YSKM129129/SRC_FOC/docs/TIGERS_FOC_REVIEW_2026-09-17.md

# Tigers 与 SRC-FOC 控制链路对照

日期：2026-09-17。基于本次读取的磁盘源码；未连接电机、示波器或调试器进行运行测量。本报告中的“确定”指代码行为确定，不代表已证实现场故障的唯一根因。

## 结论

SRC-FOC 已有完整的基本 FOC 运算链：电流采样、Clarke/Park、双 PI、逆 Park、带零序注入的 SVPWM，以及速度外环、指令斜坡、母线电压补偿和电压矢量限幅。它不是缺少某个坐标变换公式。

当前最需要补齐的是：采样窗口约束、角度与采样/输出时刻的对应关系、校准有效性验证，以及能解释故障的同步波形记录。

优先发现：

1. 默认速度模式只能输出最多 2 A 的 Iq。转矩模式的 10 A 上限在这里不起作用，这是出力受限的确定原因之一。
2. 当前调制幅值 0.8 下，固定 ADC 时刻的最坏采样余量只有约 0.04 us，不能保证所有电角度下均采到有效的低侧电流。
3. 电流环 20 kHz 使用 4 kHz 更新的角度，且允许旧角度维持接近 20 ms。没有角度时间戳补偿，对中高速和编码器干扰尤其不利。
4. 零位校准的验收条件太宽，历史校准不绑定电机、相序或极对数。校验和正确不等于电角度正确。
5. 调试模式没有通信遥测，故障后主循环阻塞在灯语中。现有数据不足以判断是哪一个限制在起作用。

这次没有修改运行固件或提高功率参数。修改前应先固定测量基线，并逐项验证，避免多个参数同时变化后无法归因。

## 源码范围与版本

Tigers 根目录：`F:/ROBOCUP/Tigers/Firmware-master/Firmware-master`。

重点阅读 `src/motor2019/drive_ctrl.c`、`drive_motor.c`、`adc.c`、`drive.c`、`usart1.c`，以及 `src/shared/math/pi_ctrl_s12.c`、`src/shared/drv/mcu_motor.c`、`src/main2019/test/test_motor.c`。也检查了 dribbler 控制入口；它采用不同的换相/电流控制方式，不能直接当作本板的 FOC 模板。

这是仓库中的 motor2019 实现，不代表 Tigers 所有代际的最新方案。它使用 STM32F0、特殊的电流测量开关序列、定时器编码器和 Hall；本板是 G474、低侧双电阻、DRV8353 和 MT6816 SPI 编码器。应借鉴设计方法，不能照抄寄存器、采样序列或 PI 数值。

本次 SRC-FOC 源码 SHA256：

| 文件 | SHA256 |
| --- | --- |
| `Core/Src/foc_control.c` | `3F3E9215C1DFFA4A81A5C977EA0CA8F14353FC991034163DE43B486B290C863E` |
| `Core/Src/adc.c` | `C9E085C2B08891D7063B9E440D262513369447463852EAF2CB354A5B123B9725` |
| `Core/Src/tim.c` | `E3ED4B2470C6BFB7179B063B625C1A07E38F8FEC038E061CD5672C65A15D7EC6` |
| `Core/Src/main.c` | `78E518367C15589B17DEBE08C63D6621758F12A5B4F9BC2B383B7A9F56AEAC6E` |

前面讨论过的“Clarke 缺 2/3”“没有速度环”“只有 0.05 电压限幅”已不适用于这份源码：Clarke 已修正，速度环已加入，限幅已变为 0.8，调制也已有零序注入。

## 主要发现

### 1. 速度环的 2 A 限制与转矩模式的 10 A 是两回事

证据：`Core/Src/main.c:18` 默认启用模拟指令，`:20` 选择 `FOC_MODE_SPEED`，`:21` 为 1000 rpm。`Core/Src/foc_control.c:31` 定义 `SPEED_LOOP_CURRENT_LIMIT=2.0f`，`:792` 开始的速度 PI 将输出限制到正负 2 A。

因此外部 CAN/SPI 指令在默认调试模式下不生效。`MAX_IQ_CURRENT=10` 只限制转矩指令路径，不会把速度环限幅放大。

按代码中的 25.1 mN*m/A 换算，2 A 对应名义轴转矩 50.2 mN*m，即 0.0502 N*m；该值还依赖 Kt 与本项目 Iq 定义一致、角度/采样正确。不能把它直接视为实测转矩，减速器输出还要乘减速比与效率。

验证：在受控负载下记录速度目标/反馈和 `iq_ref_target`。如果速度下降时 `iq_ref_target` 一直为 2 A，且实际 Iq 跟得上，当前限制就是速度环出力上限。若实际 Iq 跟不上，应先检查电压饱和与反馈，不能靠增大上限解决。

后续将电机额定电流、允许短时电流、转矩模式限制、速度环限制、软件保护阈值分别定义，并注明单位。不要直接把速度上限改成 10 A；现有板级热容量和相电流测量尚未证实支持该值。

### 2. 固定电流采样窗口没有可靠覆盖 0.8 调制范围

证据：`Core/Src/tim.c:47` 配置 170 MHz、ARR=2125、中心对齐，PWM 约 40 kHz；`:96` 将 CH4 比较值设为 170，ADC 在 CNT=0 后约 1 us 触发。`Core/Src/adc.c:48` 为同步时钟除 4，即 42.5 MHz；`:82` 每路采样 12.5 周期，12-bit 转换另需约 12.5 周期，两路顺序转换。

以 CNT=0 为时刻零，忽略触发同步延迟：

```text
ADC 触发                  1.000 us
第一路采样保持时刻         1.294 us
第一路转换结束             1.588 us
第二路采样保持时刻         1.882 us
第二路转换结束             2.176 us
```

关键是采样保持时刻必须位于有效电流窗口内；不能简单要求整个数字转换过程都早于开关沿。

当前 `svpwm()` 带零序注入。电压矢量幅值 m 时，所有角度上的最大占空比为 `0.5 + sqrt(3)*m/4`。PWM2 下，从 CNT=0 到最早高侧输入上升沿的时间为 `ARR*(1-duty_max)/170 MHz`。

| m | 最大占空比 | 最早开关指令边沿 | 距第二路理想保持时刻的余量 |
| --- | --- | --- | --- |
| 0.80 | 84.64% | 1.920 us | 0.038 us |
| 0.70 | 80.31% | 2.461 us | 0.579 us |
| 0.65 | 78.15% | 2.732 us | 0.849 us |

上述为浮点理想计算，CCR 整数截断会再减少几 ns；尚未计入 ADC 触发同步、实际栅极切换、放大器瞬态和噪声余量。故“已把 ADC 采样时间缩短”仍不足以证明 0.8 全范围可靠。

影响：在特定电角度或较大电压指令下，某一路可能读到切换期间的值或无效低侧电流，造成与电角度相关的电流纹波、抖动和误过流。这个风险只有在实际指令接近窗口边界时才直接相关；低负载低调制时不能仅凭此断定根因。

验证：记录 CCR1/2/3、ADC 原始值和触发时刻；用示波器观察 SOA/SOB 与对应低侧 Vgs。在相同低速负载下对比有充分余量的调制范围与原配置。降低限幅只用于定位，并不是最终解决高速出力的方法。

应借鉴 Tigers 的“先安排可测量的开关状态，再执行控制”：按两个被测相的实际导通窗口判定采样有效性；选择合适触发位置，或评估双 ADC 同步采样。双 ADC 方案需重新分配当前 ADC2 的母线/温度采样，不能直接修改一个开关就完成。

### 3. 角度没有与电流和 PWM 输出时刻对齐

证据：`Core/Src/foc_control.c:813` 每 10 次 40 kHz ADC 回调发起编码器读取，即约 4 kHz；`:842` 每 2 次执行一次电流环，即 20 kHz；`:904` 直接使用最近一次 `angle` 做 Park；逆 Park 又使用同一个 theta。

在读取开始的那一次 ADC 中断中，新角度尚未通过 DMA 返回，当前控制必然使用上一笔数据。现有 `enc_last_valid_ms` 是毫秒级完成时间，不是传感器角度的采样时间。

8 对极下，仅 250 us 的角度保持对应的电角度变化为：

| 转速 | 电角度变化 |
| --- | --- |
| 1000 rpm | 12 度 |
| 3000 rpm | 36 度 |
| 6000 rpm | 72 度 |
| 9000 rpm | 108 度 |

这不是每一时刻的固定误差，还未包含传感器内部延迟、SPI 传输、中断和 PWM 生效延迟。1000 rpm 时仅这一项通常不足以解释很大的转矩损失；但在更高转速下不能忽略。

`encoder_healthy()` 在 `:253` 允许最后有效角度的年龄小于 20 ms。1000 rpm、8 对极时，20 ms 已跨过约 960 度电角度。它适合作为较宽松的通信存活尺度，不适合作为继续施加正常转矩的角度有效性尺度。

Tigers 在 `drive_motor.c:145` 使用 PWM 事件触发 DMA 捕获编码器计数，`drive_ctrl.c:314` 取与电流序列对应的计数，并利用 Hall 转换做修正。这种硬件捕获不能直接搬到 SPI 编码器，但时间对应关系必须建立。

建议为角度增加微秒时间戳、序号和实际采样延迟模型。分别估算电流采样时刻的角度和 PWM 实际生效时刻的角度；有条件地采用 `theta(t)=theta_sample+omega_e*(t-t_sample)`，并限制预测时长。不要用一个固定“超前角”覆盖所有转速，也不要只提高 SPI 波特率就认为解决了角度年龄问题。

### 4. 校准成功的条件不足以证明磁场零位正确

证据：`Core/Src/foc_control.c:648` 在已有校准时跳过机械对齐；`:667` 只要求旋转量大于理想值的 25%，没有上限、稳定性或重复性验证。8 对极的理想半电周运动为 22.5 度机械角，目前超过 5.625 度就可能通过。

`:682` 用单次最终角度写入零偏。`calibration_load()` 在 `:328` 检查格式、校验和和范围，但没有相序、极对数、电机标识或校准质量记录。换相线、移动磁铁、更换电机后旧数据仍可能被接受。

影响：加载一个数学上合法但物理上错误的零偏，仍可能转动，但每安培有效转矩下降，正反转不对称或周期性抖动。仅在这个错误坐标系下观察 Id 接近零，也不能独立证明磁场零位正确。

验证：轻载状态下做多角度、正反方向、重复对齐，记录指令电角度和实测机械角；验证极对数、方向和最终保持段的角度方差。校准记录加入配置版本和质量指标，提供明确的重校准入口。不要在未保证电流测量和限流可靠前扩大开环对齐电压。

### 5. 关键波形不可见，难以区分内环和外环问题

证据：`Core/Src/main.c:76` 的调试分支只重复应用模拟命令；CAN/SPI 遥测在另一分支。正常通信模式也只是约 100 Hz 的少量瞬时读数。`FOC_PollDriverFault()` 在故障后进入无限灯语循环，无法继续从主循环发出诊断。

Tigers 的 `adc.h` 定义每 ms 20 个样本和双缓冲；`drive_ctrl.c:544` 提供记录 Iq 目标/实际、Id/Iq、电压等模式；`usart1.c:178` 同时报告电流 PI 和速度 PI 饱和标志。`mcu_motor.c:534` 提供记录阶跃的命令。100 Hz 瞬时遥测不能可靠识别几百 Hz 或 kHz 振荡，还可能混叠。

优先补充一次性 RAM 录波：以电流环频率采样 256~512 点，记录时间戳、ADC_U/V、Iu/Iv、Id/Iq、Iq 目标、Vd/Vq、CCR、角度年龄、饱和标志和状态；在故障或阶跃附近冻结，再低优先级传输。按实际每条记录大小核对内存预算，避免在高频中断内 printf 或阻塞传输。

还应记录 ADC 中断执行时间、最大执行时间、丢帧计数，以及写 CCR 到实际更新事件的相位。当前 RCR=3、40 kHz PWM、20 kHz 控制组合的平均频率合理，但平均频率不证明每次计算均赶上预装载生效期限。

### 6. 母线采样存在软件读取竞态

证据：`Core/Src/foc_control.c:78` 启动 ADC2 两通道序列后，分别轮询并读取温度和母线；`Core/Src/adc.c:133` 为单转换 EOC、AutoWait 关闭、数据保留模式。两个转换各约 1.41 us，远快于最坏中断抢占时间。

若 CPU 在第一次读取前被电流中断抢占，两次转换可能都已结束。一个 DR 寄存器并不能保存两个结果；OVR 或 EOC 合并可能导致第二次轮询超时。运行时调用忽略返回失败，母线补偿会继续使用旧值。

这是确定存在的竞态窗口，是否已触发需要统计 ADC2 OVR、超时次数和母线数据年龄。建议单独采母线通道，或用 DMA 存两路完整序列。再增加数据年龄检查，避免把通信/转换失败误判为稳定供电。

### 7. 当前保护不能当作准确的 10 A 瞬时限流

`Core/Src/foc_control.c:884` 实际判定是连续 30 个 20 kHz 控制样本越限，即约 1.5 ms 的资格窗口；附近注释仍写 3 次、150 us。`:863` 启动 blank 阶段有 20 个样本，即约 1 ms，在使能桥臂和施加零矢量时跳过软件相电流保护。

这些行为不一定是抖动根因，但会让“没有报错”等同于“电流安全”的判断失效。转矩目标上限和保护阈值均为 10 A，也缺少纹波与超调余量。DRV8353 自身 OCP 仍然存在，但它的 VDS/分流输入阈值不能直接等同于这条软件 10 A 阈值。

应重新核对实物额定电流和硬件保护；区分快速严重过流、短时滤波与持续热限制。保留故障快照，修正陈旧注释；不能用继续延长去抖或扩大 blank 来掩盖采样错误。

## Tigers 真正值得借鉴的部分

| 设计 | Tigers 证据 | 本项目应用方式 |
| --- | --- | --- |
| 测量状态与控制共同设计 | `drive_motor.c:44` 的测量序列、`:145` 编码器捕获；`drive_ctrl.c:298` 读取 U/V/W/W/V/U/零点 | 固定有效低侧采样窗口，给角度和 ADC 数据建立时间关系；不照搬其特殊测量脉冲 |
| 对称采样与零点参考 | `drive_ctrl.c:440` 对前后相电流样本平均，并减去本序列零点 | 对本板分别校准偏置、增益和符号；验证零点漂移。不能在有电流时任意追踪零点 |
| 清楚的物理单位 | `drive_ctrl.c` 开头注明电流 mA、电压 mV、20 kHz/1 kHz 频率 | 明确 Iq 是相峰值还是 RMS、Kt 与该定义是否匹配；电压单位与调制量分离 |
| 有参数辨识依据 | `test_motor.c:15` 多角度阶跃、`:131` 求 R/L、`:137` 推荐 PI | 在低风险电流范围下测实际电气响应和延迟，再整定 PI；不要照抄其 8 A 试验幅值 |
| 可定位问题的遥测 | `adc.c:150` 双缓冲；`usart1.c:178` 饱和标志；`mcu_motor.c:534` 阶跃录制 | 先做短时高速 RAM 波形，记录限幅来源，再考虑上位机自动分析 |
| 故障隔离与失联处理 | `drive_ctrl.c:146` 指令超时；`drive.c` 独立看门狗 | 正式机器人模式加入有定义的失联停机、故障状态机和非阻塞诊断 |

Tigers 的 `PICtrlS12SetAntiJitter()` 是速度环近零误差时缩小输出的功能，不是修复采样、相序或电角度错误的通用滤波器。盲目移植可能牺牲小负载下的静态调节能力。该版本 PI 主要是积分项和输出限幅，也不能宣称其已经具有本项目所需的完整电压矢量抗饱和。

G474 有 FPU，没有必要为了模仿 STM32F0 实现而整体改用定点数、查表或寄存器裸写。先测执行时间，再优化真正的热点。

## 到底还缺什么

必须优先验证或补齐：采样窗口保证；电流标定与极性验证；有质量判断的角度校准；带时间戳的角度对齐；同步录波和限幅标志；基于实测 R/L/延迟的内环整定；可靠母线采样。

已有但需要验收：速度外环、指令斜坡、正确等幅值 Clarke、零序 SVPWM、电压矢量限幅、积分回算。不能把“代码里有”当作“实物上有效”。

后续性能优化：dq 交叉耦合与反电动势前馈、速度相关角度预测、必要时的死区补偿。没有这些并不必然导致低速抖动；先用低速电流阶跃验证基本内环，再决定需要哪项。位置环、弱磁和 MTPA 不是本次低速抖动的默认解决方案。

## 最小实验顺序

1. 固定硬件和固件版本。确认实际烧录文件、模式、负载、母线电压；确认 U15/U16 是否真的与 DRV8353 输出隔离。以前注释中的硬件假设不能代替实物检查。
2. 桥臂禁止时测 ADC 偏置和噪声，再在受控已知电流下验证增益、正负符号和 U/V 相对应关系。1 mOhm、40 倍时 1 A 对应约 40 mV、49.6 ADC counts。电源平均电流不能替代相电流测量。
3. 手转检查 MT6816 全周连续性、丢帧和磁铁偏心；随后用小电流、多角度对齐验证极对数和零偏重复性。
4. 在固定测试夹具和受控负载下，用转矩模式隔离速度外环，做小幅正负 Iq 阶跃并短时录波。必要的静止测试必须限流、限时，不能用手抓轴测转矩。
5. 判断内部电流跟踪：若小信号也振荡，优先检查采样、角度和内环；若只在大调制/特定电角度失真，重点检查采样窗口；若只在转速提高时恶化，重点检查角度年龄和输出延迟。
6. 内环稳定后启用速度环，逐步增加可量化负载。若 Iq 目标顶到 2 A 且实测跟踪良好，再依据电机/桥臂额定值调整速度电流限幅；若只是速度模式振荡，分析速度滤波延迟和外环 PI。
7. 用测力臂/测力计或测功机获取轴转矩：`T=F*r`。测多个 Iq 的正反方向响应，区分电流标定、Kt 定义、零偏、机械传动损失。只凭手感无法定量评价“转矩不够”。

首轮必须得到的证据是：同一时间轴上的 Iq 目标/实际、Id、实际施加电压、采样窗口余量、角度年龄和速度。它们能把“力矩不足”分成指令受限、电流跟不上、坐标方向错误和机械损失四类。

## 验证边界

已完成源码路径追踪、HAL 轮询行为检查，以及采样窗口/角度年龄的数值核算。没有修改固件，因此未重复运行编译；也没有把静态分析当作电机运行验证。最终根因仍需上述板上波形或负载数据确认。
