YSKM129129/SRC_FOC/FOC_cubeMX/BOM_FOC-MainBoard_PCB1_2026-09-11.xlsx

No. | Quantity | Comment | Designator | Footprint | Value | Manufacturer Part | Manufacturer | Supplier Part | Supplier | Name | Unique ID
1 | 3 | 4.7uF | C1,C2,C3 | C0603 | 4.7uF | CL10A475KO8NNNC | SAMSUNG(三星) | C19666 | LCSC | 4.7uF | gge2,gge3,gge4
2 | 6 | 1uF | C4,C5,C12,C24,C48,C54 | C0603 | 1uF | CL10B105KA8NNNC | SAMSUNG(三星) | C29936 | LCSC | 1uF | gge5,gge6,gge18,gge85,gge196,gge202
3 | 3 | 100nF | C6,C7,C28 | C0603 | 100nF | CC0603KRX7R0BB104 | YAGEO(国巨) | C113803 | LCSC | 100nF | gge7,gge8,gge15_0
4 | 2 | 4.7uF | C8,C49 | C0603 | 4.7uF | CL10A475KA8NQNC | SAMSUNG(三星) | C69335 | LCSC | 4.7uF | gge9,gge197
5 | 2 | 22pF | C9,C10 | C0603 | 22pF | CL10C220JB8NNNC | SAMSUNG(三星) | C1653 | LCSC | 22pF | gge11,gge12
6 | 2 | 1nF | C13,C14 | C0603 | 1nF | CL10B102KB8NNNC | SAMSUNG(三星) | C1588 | LCSC | 1nF | gge23,gge24
7 | 6 | 3.3nF | C15,C41,C42,C44,C45,C47 | C0805 | 3.3nF | 0805B332K101NT | FH(风华) | C2836776 | LCSC | 3.3nF | gge30,gge30_0,gge30_1,gge36,gge36_0,gge36_1
8 | 3 | 100nF | C16,C43,C46 | C0805 | 100nF | 0805B104K101NT | FH(风华) | C89258 | LCSC | 100nF | gge35,gge35_0,gge35_1
9 | 7 | 100nF | C17,C19,C20,C37,C38,C39,C50 | C0603 | 100nF | CL10B104KB8NNNC | SAMSUNG(三星) | C1591 | LCSC | 100nF | gge73,gge76,gge79,gge110,gge111,gge112,gge198
10 | 1 | 10uF | C18 | C0603 | 10uF | CL10A106MA8NRNC | SAMSUNG(三星) | C96446 | LCSC | 10uF | gge75
11 | 5 | 2.2uF | C21,C22,C23,C25,C26 | C0603 | 2.2uF | CL10A225KO8NNNC | SAMSUNG(三星) | C23630 | LCSC | 2.2uF | gge80,gge81,gge83,gge87,gge88
12 | 1 | 100uF | C27 | CAP-SMD_BD6.3-L6.6-W6.6-FD-1 | 100uF | JVJ25V100M6x5 | JIERR(捷而瑞) | C46550402 | LCSC | 100uF | gge220
13 | 1 | 1uF | C51 | C0603 | 1uF | CC0603KRX7R7BB105 | YAGEO(国巨) | C106248 | LCSC | 1uF | gge199
14 | 1 | 100nF | C52 | C0603 | 100nF | CL10B104KO8NNNC | SAMSUNG(三星) | C66501 | LCSC | 100nF | gge200
15 | 1 | 47nF | C53 | C0603 | 47nF | AC0603KRX7R0BB473 | YAGEO(国巨) | C469624 | LCSC | 47nF | gge201
16 | 6 | 47uF | C56,C57,C58,C59,C60,C61 | C1210 | 47uF | HGC1210R5476M250NSVK | Chinocera(华瓷) | C7432791 | LCSC | 47uF | gge214,gge215,gge216,gge217,gge218,gge219
17 | 2 | AM-1015B-M | CN4,CN5 | CONN-TH_AM-1015B-M |  | AM-1015B-M | AMASS(艾迈斯) | C90631 | LCSC | AM-1015B-M | gge64,gge65
18 | 1 | XT60PW-M | CN6 | CONN-TH_XT60PW-M |  | XT60PW-M | AMASS(艾迈斯) | C98732 | LCSC | XT60PW-M | gge66
19 | 1 | HC-XHB-8AW | CN10 | CONN-TH_HC-XHB-8AW |  | HC-XHB-8AW | HCTL(华灿天禄) | C2845511 | LCSC | HC-XHB-8AW | gge183
20 | 10 | BAT41KFILM | D1,D4,D5,D6,D7,D8,D9,D10,D11,D12 | SOD-523_L1.2-W0.8-LS1.6-RD |  | BAT41KFILM | ST(意法半导体) | C73150 | LCSC | BAT41KFILM | gge27,gge27_0,gge27_1,gge33,gge33_0,gge33_1,gge34,gge34_0,gge34_1,gge109
21 | 2 | SMBJ70A | D2,D3 | SMB_L4.5-W3.6-LS5.4-RD |  | SMBJ70A | BORN(伯恩半导体) | C152089 | LCSC | SMBJ70A | gge90,gge91
22 | 1 | 33uH | L1 | IND-SMD_L12.3-W12.3 | 33uH | SMDRI127-330MT | SXN(顺翔诺) | C9400 | LCSC | 33uH | gge74
23 | 1 | LTST-C190KSKT | LED1 | LED0603-RD |  | LTST-C190KSKT | LITEON(光宝) | C125095 | LCSC | LTST-C190KSKT | gge69
24 | 1 | GL0603UG01 | LED2 | LED0603-RD |  | GL0603UG01 | Guiguang light(桂光光电) | C51933293 | LCSC | GL0603UG01 | gge71
25 | 6 | BSC028N06NS | Q1,Q2,Q3,Q4,Q5,Q6 | PG-TDSON-8_L5.0-W6.0-P1.27-LS6.2-BL-EP |  | BSC028N06NS | Infineon(英飞凌) | C148250 | LCSC | BSC028N06NS | gge25,gge25_0,gge25_1,gge26,gge26_0,gge26_1
26 | 4 | 10kΩ | R1,R2,R13,R17 | R0603 | 10kΩ | 0603WAF1002T5E | UNI-ROYAL(厚声) | C25804 | LCSC | 10kΩ | gge14,gge16,gge104,gge108
27 | 2 | 22Ω | R3,R4 | R0603 | 22Ω | 0603WAF220JT5E | UNI-ROYAL(厚声) | C23345 | LCSC | 22Ω | gge21,gge22
28 | 6 | 75Ω | R5,R7,R18,R21,R24,R26 | R0805 | 75Ω | 0805W8J0750T5E | UNI-ROYAL(厚声) | C25327 | LCSC | 75Ω | gge28,gge28_0,gge28_1,gge32,gge32_0,gge32_1
29 | 6 | 51Ω | R6,R19,R20,R22,R25,R27 | R0805 | 51Ω | 0805W8J0510T5E | UNI-ROYAL(厚声) | C25318 | LCSC | 51Ω | gge29,gge29_0,gge29_1,gge37,gge37_0,gge37_1
30 | 2 | 1kΩ | R8,R9 | R0603 | 1kΩ | RC0603FR-071KL | YAGEO(国巨) | C22548 | LCSC | 1kΩ | gge68,gge70
31 | 1 | 118kΩ | R10 | R0603 | 118kΩ | FRC0603F1183TS | FOJAN(富捷) | C5126230 | LCSC | 118kΩ | gge77
32 | 3 | 22.1kΩ | R11,R29,R31 | R0603 | 22.1kΩ | FRC0603F2212TS | FOJAN(富捷) | C2960862 | LCSC | 22.1kΩ | gge78,gge203,gge204
33 | 1 | 0Ω | R12 | R1206 | 0Ω | RE1206F1R000 | JIERR(捷而瑞) | C46961765 | LCSC | 0Ω | gge89
34 | 1 | 100kΩ | R14 | R0603 | 100kΩ | FRC0603F1003TS | FOJAN(富捷) | C2906980 | LCSC | 100kΩ | gge105
35 | 1 | 7.5kΩ | R15 | R0603 | 7.5kΩ | RT0603BRD077K5L | YAGEO(国巨) | C728597 | LCSC | 7.5kΩ | gge106
36 | 1 | SMD0603-100-6 | R16 | F0603 |  | SMD0603-100-6 | R+O(宏嘉诚) | C46640966 | LCSC | SMD0603-100-6 | gge107
37 | 2 | 1mΩ | R23,R30 | RES-SMD_L6.3-W3.2_R2512 | 1mΩ | RE2512F3R001 | JIERR(捷而瑞) | C46961745 | LCSC | 1mΩ | gge31_0,gge31_1
38 | 1 | 120Ω | R32 | R0603 | 120Ω | FRC0603F1200TS | FOJAN(富捷) | C2906988 | LCSC | 120Ω | gge206
39 | 1 | 10kΩ | R54 | R0603 | 10kΩ | FRC0603J103 TS | FOJAN(富捷) | C2930027 | LCSC | 10kΩ | gge28_2
40 | 1 | SS-12D10L5 | SW2 | SW-TH_SS-12D10L5 |  | SS-12D10L5 | XKB Connection(中国星坤) | C319012 | LCSC | SS-12D10L5 | gge67
41 | 1 | STM32G474CBT6TR | U1 | LQFP-48_L7.0-W7.0-P0.50-LS9.0-BL_1 |  | STM32G474CBT6TR | ST(意法半导体) | C5270356 | LCSC | STM32G474CBT6TR | gge1
42 | 1 | ZX-QC4545-3.5TP | U2 | KEY-SMD_4P-L4.5-W4.5-P3.00-LS6.9 |  | ZX-QC4545-3.5TP | Megastar(兆星) | C7470170 | LCSC | ZX-QC4545-3.5TP | gge13
43 | 3 | PZ1608D102-R80TF | U3,U7,U9 | L0603 |  | PZ1608D102-R80TF | Sunlord(顺络) | C279752 | LCSC | PZ1608D102-R80TF | gge17,gge82,gge86
44 | 1 | DRV8353FSRTAR | U4 | WQFN-40_L6.0-W6.0-P0.50-TL-EP4.5 |  | DRV8353FSRTAR | TI(德州仪器) | C1518717 | LCSC | DRV8353FSRTAR | gge195
45 | 2 | ZX-XH2.54-6PWZ | U5,U14 | CONN-TH_6P-P2.50_ZX-XH2.54-6PWZ |  | ZX-XH2.54-6PWZ | Megastar(兆星) | C7429645 | LCSC | ZX-XH2.54-6PWZ | gge207,gge207_0
46 | 1 | LMR51610XDBVR | U6 | SOT-23-6_L2.9-W1.6-P0.95-LS2.8-BR |  | LMR51610XDBVR | TI(德州仪器) | C20539658 | LCSC | LMR51610XDBVR | gge72
47 | 1 | TLV75733PDBVR | U8 | SOT-23-5_L2.9-W1.6-P0.95-LS2.8-BL |  | TLV75733PDBVR | TI(德州仪器) | C485517 | LCSC | TLV75733PDBVR | gge84
48 | 1 | ZX-XH2.54-3PWZ | U10 | HDR-TH_3P-P2.50_ZX-XH2.54-3PWZ |  | ZX-XH2.54-3PWZ | Megastar(兆星) | C7429642 | LCSC | ZX-XH2.54-3PWZ | gge205
49 | 1 | NTCS0603E3473JHT | U11 | R0603 |  | NTCS0603E3473JHT | VISHAY(威世) | C3039719 | LCSC | NTCS0603E3473JHT | gge103
50 | 1 | TJA1050T/CM,118 | U12 | SOIC-8_L5.0-W4.0-P1.27-LS6.0-BL |  | TJA1050T/CM,118 | NXP(恩智浦) | C6952 | LCSC | TJA1050T/CM,118 | gge114
51 | 2 | INA240A1DR | U15,U16 | SOIC-8_L5.0-W4.0-P1.27-LS6.0-BL |  | INA240A1DR | TI(德州仪器) | C2060769 | LCSC | INA240A1DR | gge208,gge209
52 | 1 | ZX-XH2.54-6PZZ | U32 | CONN-TH_6P-P2.50_ZX-XH2.54-6PZZ |  | ZX-XH2.54-6PZZ | Megastar(兆星) | C7429636 | LCSC | ZX-XH2.54-6PZZ | gge194
53 | 1 | 8MHz | X1 | CRYSTAL-SMD_4P-L3.2-W2.5-BL | 8MHz | X32258MSB4SI | YXC(扬兴晶振) | C2682774 | LCSC | 8MHz | gge10
