YSKM129129/SRC_FOC/(list of files, drawings)

Other design files:
FOC_cubeMX/ProPrj_SRC_Robot2025_V1.0_2026-09-06.epro
