YSKM129129/SRC_FOC/FOC_cubeMX/ROBOCUP.ioc

Mcu.UserName=STM32G474CBTx
PA0.GPIO_Label=ADC_IU
PA0.Signal=ADC1_IN1
PA1.GPIO_Label=ADC_IV
PA1.Signal=ADC1_IN2
PA10.GPIO_Label=PWM_W
PA10.Signal=S_TIM1_CH3
PA11.Signal=FDCAN1_RX
PA12.Signal=FDCAN1_TX
PA13.Signal=SYS_JTMS-SWDIO
PA14.Signal=SYS_JTCK-SWCLK
PA2.GPIO_Label=LED2
PA2.Signal=GPIO_Output
PA3.GPIO_Label=LED1
PA3.Signal=GPIO_Output
PA4.GPIO_Label=ADC_V
PA4.Signal=ADC2_IN17
PA5.Signal=SPI1_SCK
PA6.Signal=SPI1_MISO
PA7.Signal=SPI1_MOSI
PA8.GPIO_Label=PWM_U
PA8.Signal=S_TIM1_CH1
PA9.GPIO_Label=PWM_V
PA9.Signal=S_TIM1_CH2
PB0.GPIO_Label=DRV_CS
PB0.Signal=GPIO_Output
PB12.GPIO_Label=SPI2_CS
PB12.Signal=GPIO_Output
PB13.Signal=SPI2_SCK
PB14.Signal=SPI2_MISO
PB15.Signal=SPI2_MOSI
PB2.GPIO_Label=MT6816_CS
PB2.Signal=GPIO_Output
PB3.Signal=SPI3_SCK
PB4.Signal=SPI3_MISO
PB5.Signal=SPI3_MOSI
PB6.Signal=USART1_TX
PB7.Signal=USART1_RX
PC14-OSC32_IN.GPIO_Label=DRV_ENBLE
PC14-OSC32_IN.Signal=GPIO_Output
PC15-OSC32_OUT.GPIO_Label=DRV_cotr
PC15-OSC32_OUT.Signal=GPIO_Output
PF0-OSC_IN.Signal=RCC_OSC_IN
PF1-OSC_OUT.Signal=RCC_OSC_OUT
