YSKM129129/SRC_FOC/Core/Inc/main.h

#define DRV_ENBLE_Pin GPIO_PIN_14
#define DRV_ENBLE_GPIO_Port GPIOC
#define DRV_cotr_Pin GPIO_PIN_15
#define DRV_cotr_GPIO_Port GPIOC
#define ADC_IU_Pin GPIO_PIN_0
#define ADC_IU_GPIO_Port GPIOA
#define ADC_IV_Pin GPIO_PIN_1
#define ADC_IV_GPIO_Port GPIOA
#define LED2_Pin GPIO_PIN_2
#define LED2_GPIO_Port GPIOA
#define LED1_Pin GPIO_PIN_3
#define LED1_GPIO_Port GPIOA
#define ADC_V_Pin GPIO_PIN_4
#define ADC_V_GPIO_Port GPIOA
#define DRV_CS_Pin GPIO_PIN_0
#define DRV_CS_GPIO_Port GPIOB
#define MT6816_CS_Pin GPIO_PIN_2
#define MT6816_CS_GPIO_Port GPIOB
#define SPI2_CS_Pin GPIO_PIN_12
#define SPI2_CS_GPIO_Port GPIOB
#define PWM_U_Pin GPIO_PIN_8
#define PWM_U_GPIO_Port GPIOA
#define PWM_V_Pin GPIO_PIN_9
#define PWM_V_GPIO_Port GPIOA
#define PWM_W_Pin GPIO_PIN_10
#define PWM_W_GPIO_Port GPIOA
