YSKM129129/SRC_FOC/(commit log)

2026-09-14 2026.9.14First save
    [BOM_FOC-MainBoard_PCB1_2026-09-11.xlsx, ProPrj_SRC_Robot2025_V1.0_2026-09-06.epro]
2026-09-15 SPI2配置
2026-09-16 add DRV8353 driver
2026-09-17 fix some bug, especially Park and Clark Transform
    [ROBOCUP.ioc, foc_can.c, foc_control.c, foc_control.h]
2026-09-17 basically realize current loop
2026-09-17 update the encoder commuication frequency
2026-09-17 add velocity loop
